projectswyaneth/ultra-precision-vi-meter/firmware/Core/Inc/main.h

#define PB6_Pin GPIO_PIN_6
#define PB6_GPIO_Port GPIOB
#define PB7_Pin GPIO_PIN_7
#define PB7_GPIO_Port GPIOB
#define PB8_Pin GPIO_PIN_8
#define PB8_GPIO_Port GPIOB
